H3ndrik-Jan/EA-UTA12-interface/pictures/front.jpg

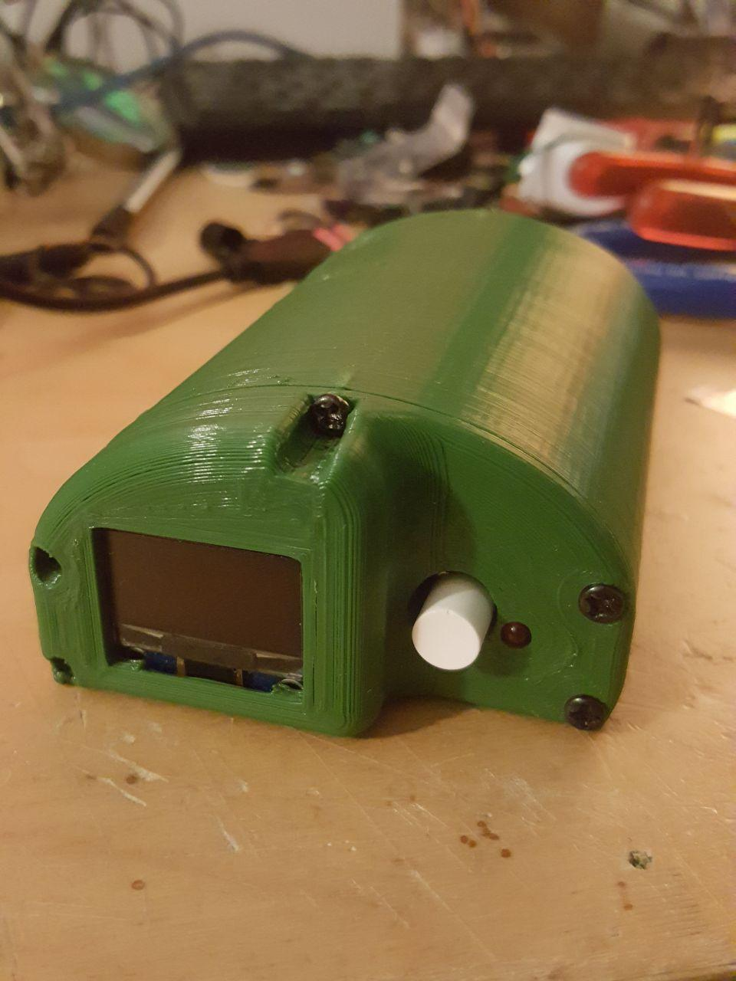
pictures/front.jpg
