H3ndrik-Jan/EA-UTA12-interface/device/hardware/Schema_fixed.pdf

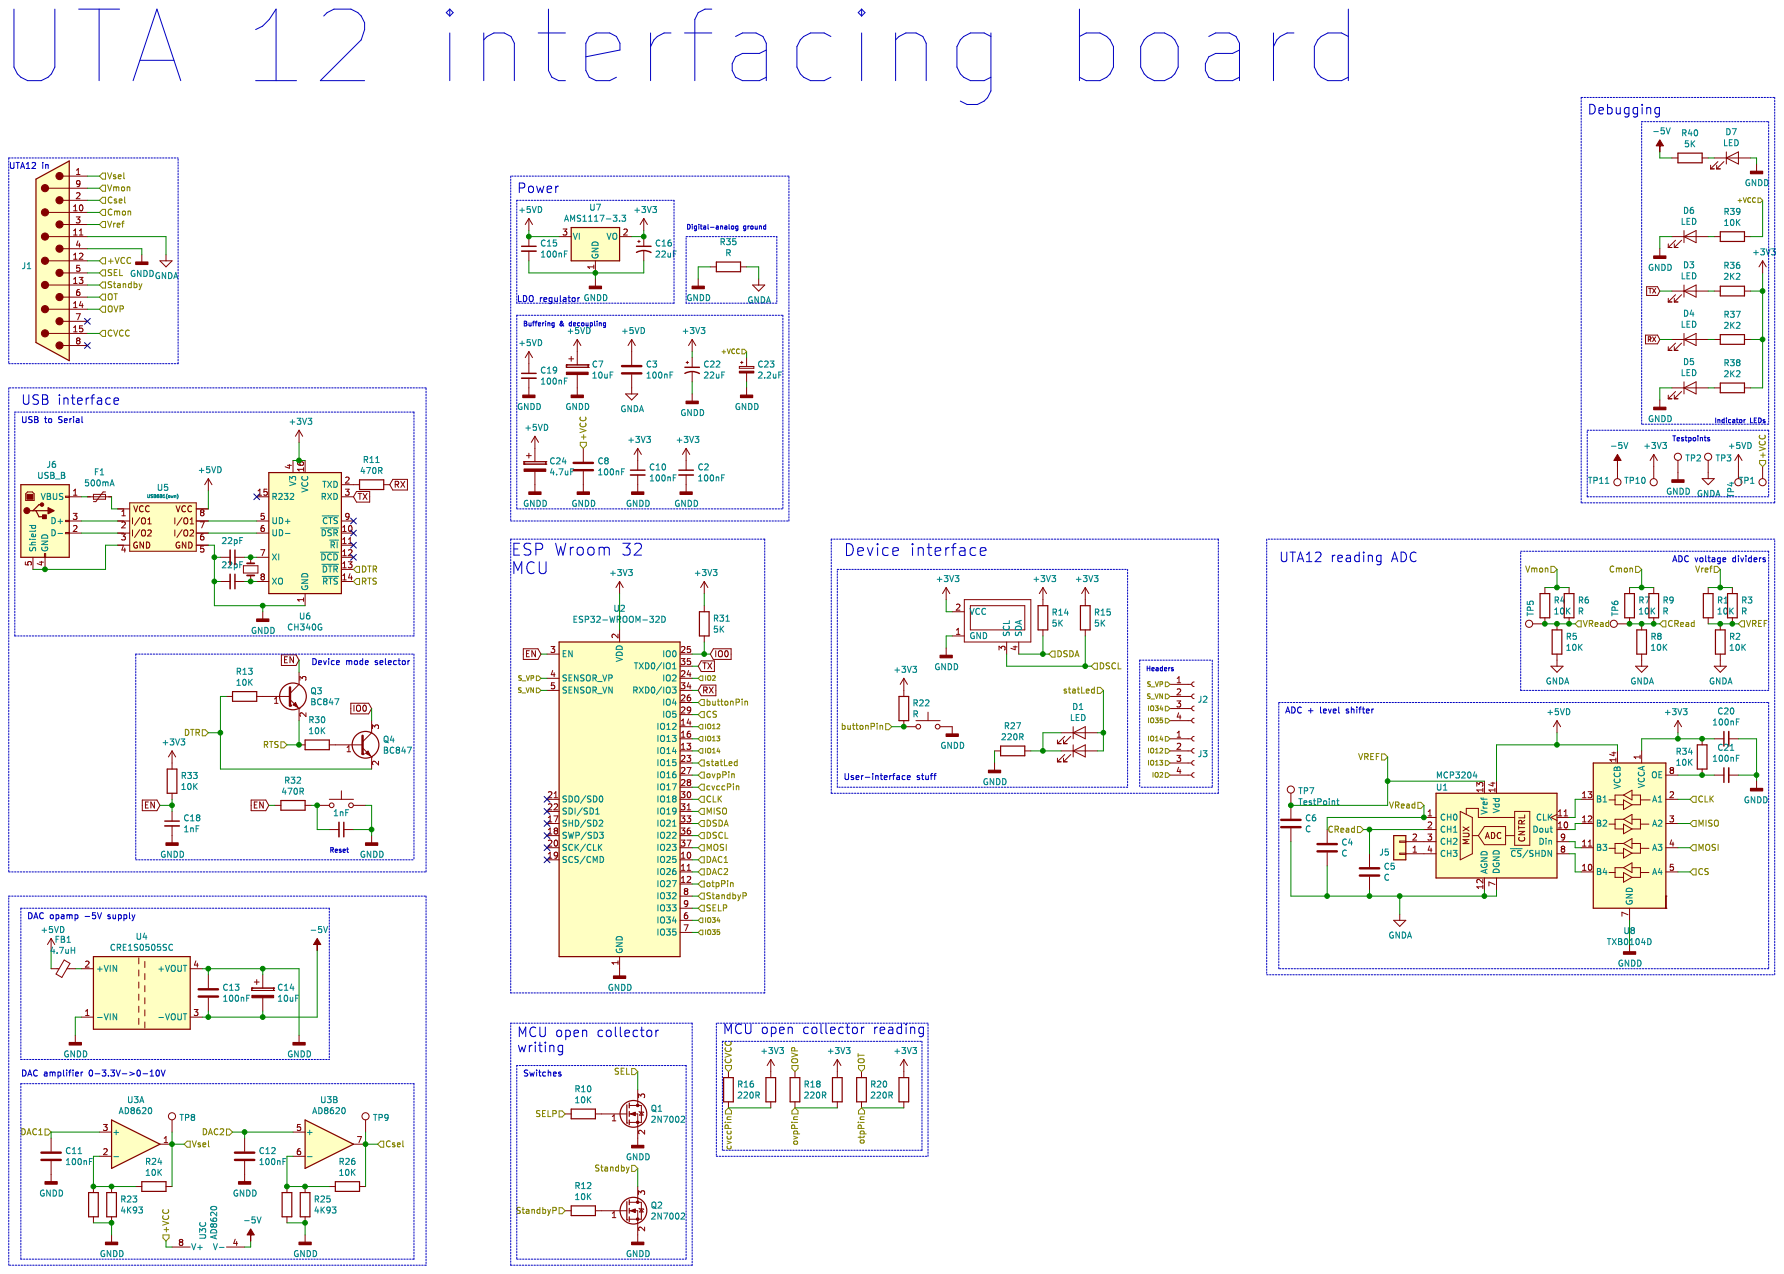
[picture p11: page 1]
